UAlberta-EcoCar/DC-Motor-Controller/README.md

# DC-Motor-Controller
Our custom DC brushed motor controller
