UAlberta-EcoCar/DC-Motor-Controller/Motor Controller Code/README.txt

Source files to run on the motor controller's MCU go here
