UAlberta-EcoCar/DC-Motor-Controller/Motor Controller PCB/Motor Controller Logic Board/README.txt

If we deside to use an external mountable PCB for the voltage regulators,
it'll go here.
