UAlberta-EcoCar/DC-Motor-Controller/Motor Controller PCB/Motor Controller Power Board/Motor Controller Gerber 2017_10_10/README.txt

Schematic and Board files for the the motor controller here
