UAlberta-EcoCar/DC-Motor-Controller/Motor Controller PCB/Motor Controller Power Board/MotorControllerMainBoard.brd

## EAGLE design Motor Controller PCB/Motor Controller Power Board/MotorControllerMainBoard.brd (2017-10-19)

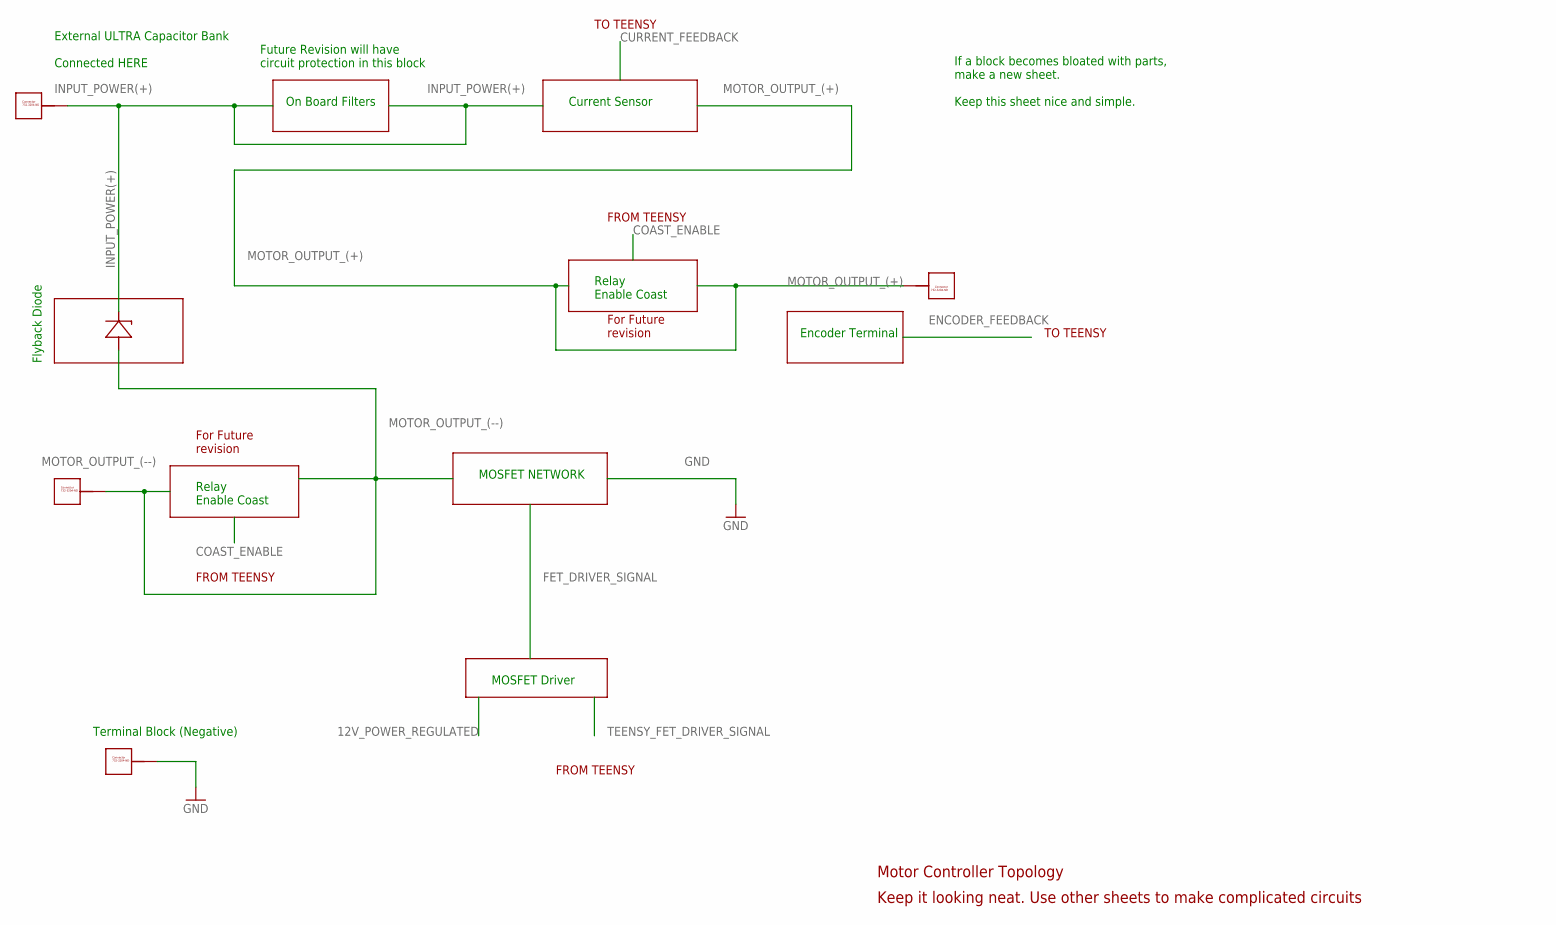
[picture p1: schematic MotorControllerMainBoard.sch, sheet 1, Main Board Topology]

Parts:
U$5: FLYBACK; TO
U$12, U$14, U$15, U$16: 732-3204-ND_CONNECTOR; 732-3204-ND

Connections:
GND: U$14.P$1, U$14.P$2, U$14.P$3, U$14.P$4, U$14.P$5, U$14.P$6, U$14.P$7, U$14.P$8, U$14.P$9, U$14.P$10; also elsewhere on the board
INPUT_POWER(+): U$5.CATHODE, U$12.P$1, U$12.P$2, U$12.P$3, U$12.P$4, U$12.P$5, U$12.P$6, U$12.P$7, U$12.P$8, U$12.P$9, U$12.P$10; also elsewhere on the board
MOTOR_OUTPUT_(+): U$15.P$1, U$15.P$2, U$15.P$3, U$15.P$4, U$15.P$5, U$15.P$6, U$15.P$7, U$15.P$8, U$15.P$9, U$15.P$10; also elsewhere on the board
MOTOR_OUTPUT_(--): U$5.ANODE, U$16.P$1, U$16.P$2, U$16.P$3, U$16.P$4, U$16.P$5, U$16.P$6, U$16.P$7, U$16.P$8, U$16.P$9, U$16.P$10; also elsewhere on the board

Notes on the sheet:
Current Sensor
On Board Filters
Flyback Diode
MOSFET NETWORK
If a block becomes bloated with parts, make a new sheet. Keep this sheet nice and simple.
MOSFET Driver
Encoder Terminal
TO TEENSY
FROM TEENSY
External ULTRA Capacitor Bank Connected HERE
Relay Enable Coast
Motor Controller Topology
Keep it looking neat. Use other sheets to make complicated circuits
For Future revision
Terminal Block (Negative)
Future Revision will have circuit protection in this block

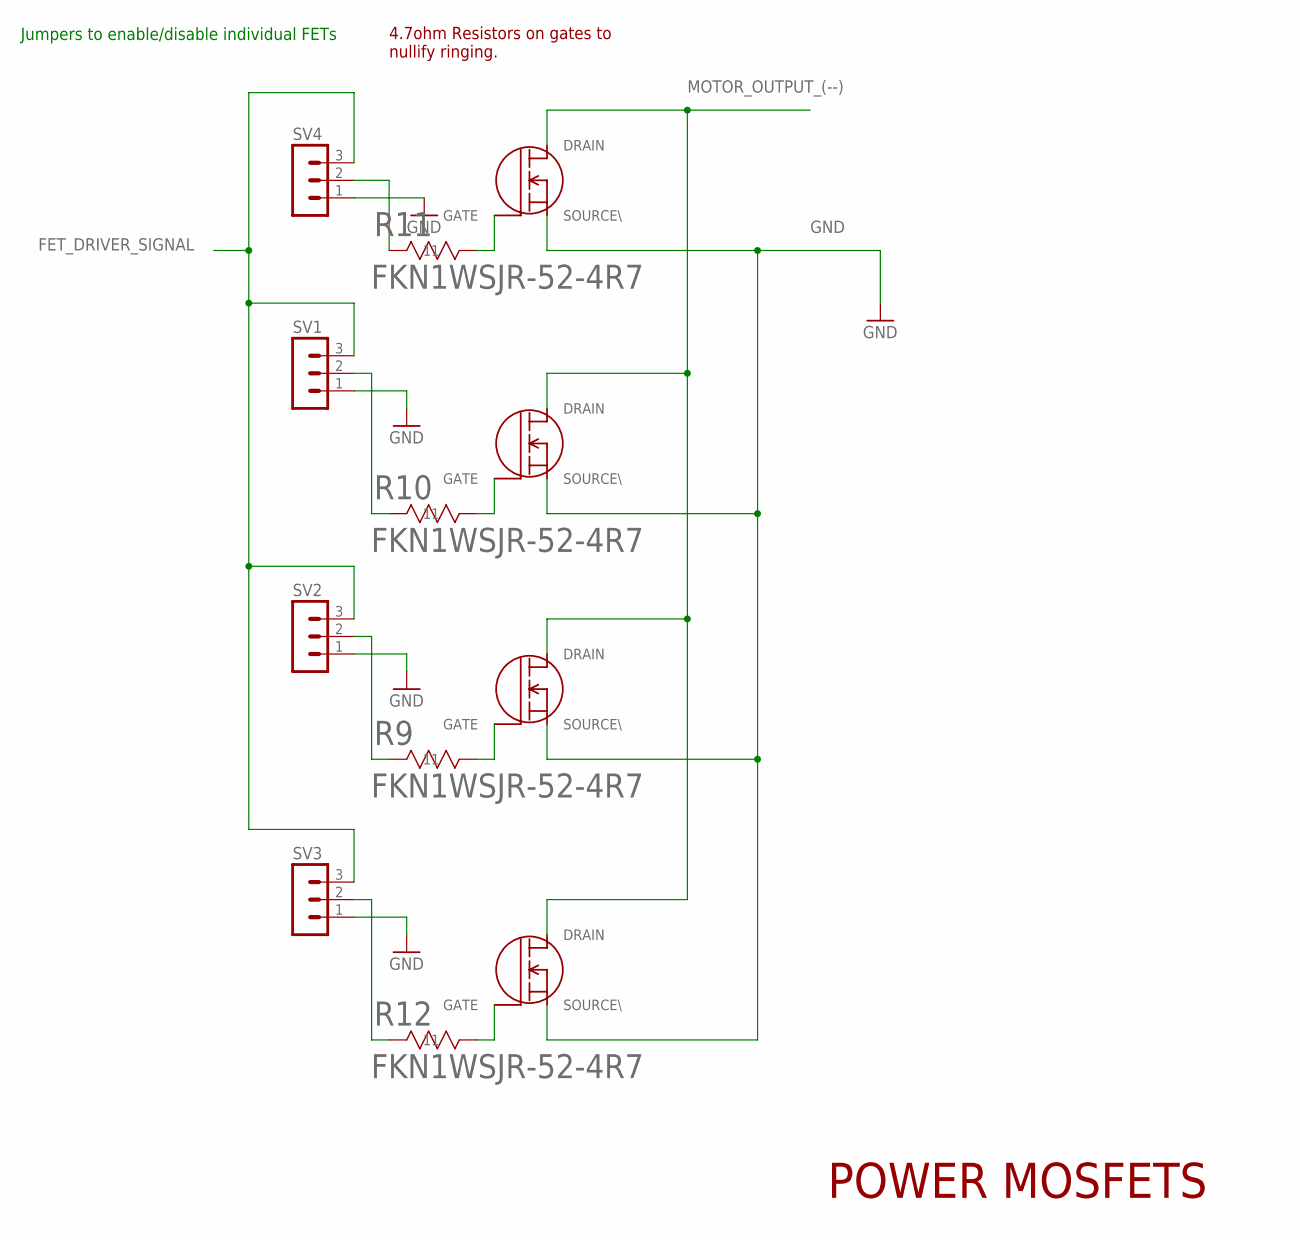
[picture p2: schematic MotorControllerMainBoard.sch, sheet 2, MOSFET NETWORK]

Parts:
R9, R10, R11, R12: FKN1WSJR-52-4R7; YAG_FKN50
SV1, SV2, SV3, SV4: MA03-1
U$1, U$2, U$3, U$4: NTMFS5C426NT1G; DNF5

Connections:
FET_DRIVER_SIGNAL: SV1.3, SV2.3, SV3.3, SV4.3; also elsewhere on the board
GND: SV1.1, SV2.1, SV3.1, U$1.SOURCE (SOURCE\), U$2.SOURCE (SOURCE\), U$3.SOURCE (SOURCE\), U$4.SOURCE (SOURCE\); also elsewhere on the board
MOTOR_OUTPUT_(--): U$1.DRAIN, U$2.DRAIN, U$3.DRAIN, U$4.DRAIN; also elsewhere on the board
unnamed: R10.2 (22), U$2.GATE
unnamed: R10.1 (11), SV1.2
unnamed: R12.1 (11), SV3.2
unnamed: R11.1 (11), SV4.2
unnamed: R11.2 (22), U$1.GATE
unnamed: R9.2 (22), U$3.GATE
unnamed: R12.2 (22), U$4.GATE
unnamed: R9.1 (11), SV2.2

Notes on the sheet:
POWER MOSFETS
Jumpers to enable/disable individual FETs
4.7ohm Resistors on gates to nullify ringing.

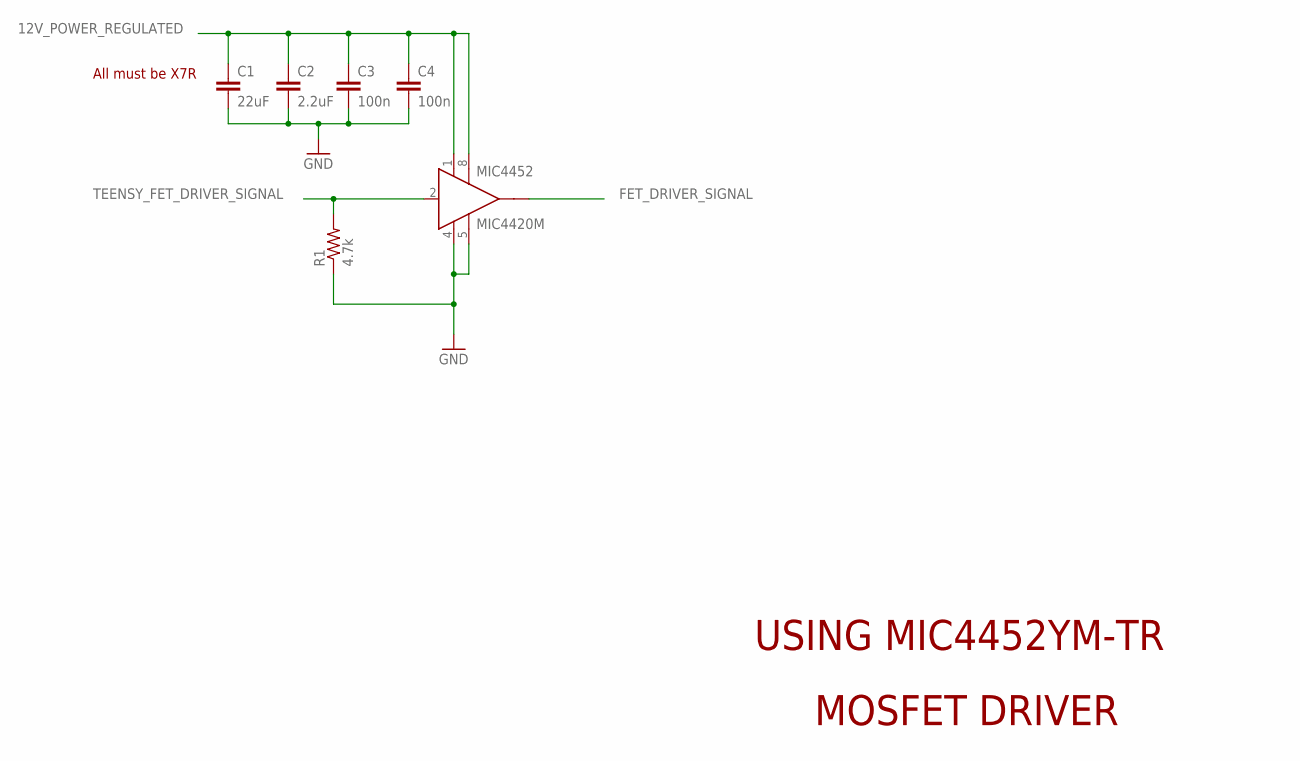
[picture p3: schematic MotorControllerMainBoard.sch, sheet 3, MOSFET Driver]

Parts:
C1: 22uF; C1206
C2: 2.2uF; C0805
C3, C4: 100n; C0603
MIC4452: MIC4420M; SO-08
R1: 4.7k; R0805

Connections:
12V_POWER_REGULATED: C1.1, C2.1, C3.1, C4.1, MIC4452.1 (VS), MIC4452.8 (VS1); also elsewhere on the board
FET_DRIVER_SIGNAL: MIC4452.6 (OUT); also elsewhere on the board
GND: C1.2, C2.2, C3.2, C4.2, MIC4452.4 (GND), MIC4452.5 (GND1), R1.1; also elsewhere on the board
TEENSY_FET_DRIVER_SIGNAL: MIC4452.2 (IN), R1.2; also elsewhere on the board

Notes on the sheet:
MOSFET DRIVER
USING MIC4452YM-TR
All must be X7R

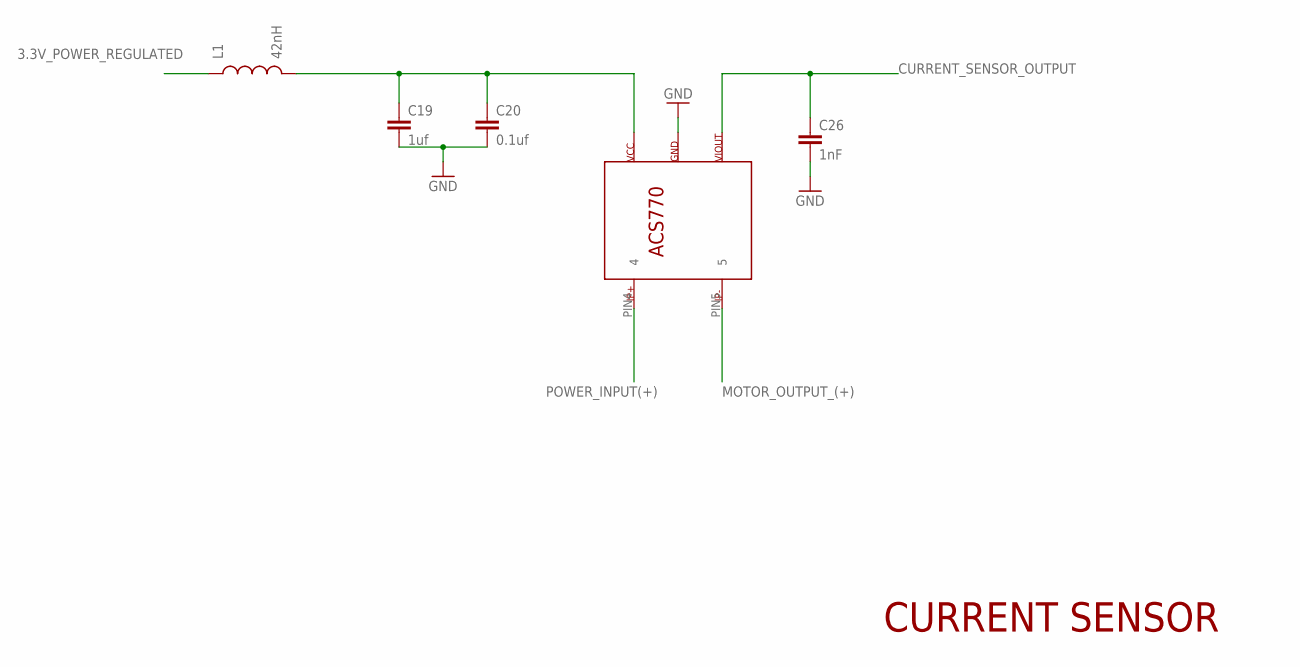
[picture p4: schematic MotorControllerMainBoard.sch, sheet 4, Current Sensor]

Parts:
C19: 1uf; C0805
C20: 0.1uf; C0805
C26: 1nF; C0805
L1: 42nH; 0805
U$9: ACS770LCB_CURRENTSENSOR

Connections:
3.3V_POWER_REGULATED: L1.1; also elsewhere on the board
CURRENT_SENSOR_OUTPUT: C26.1, U$9.PIN3 (3); also elsewhere on the board
GND: C19.2, C20.2, C26.2, U$9.PIN2 (2); also elsewhere on the board
MOTOR_OUTPUT_(+): U$9.PIN5 (5); also elsewhere on the board
unnamed: C19.1, C20.1, L1.2, U$9.PIN1 (1)
POWER_INPUT(+): U$9.PIN4 (4)

Notes on the sheet:
CURRENT SENSOR

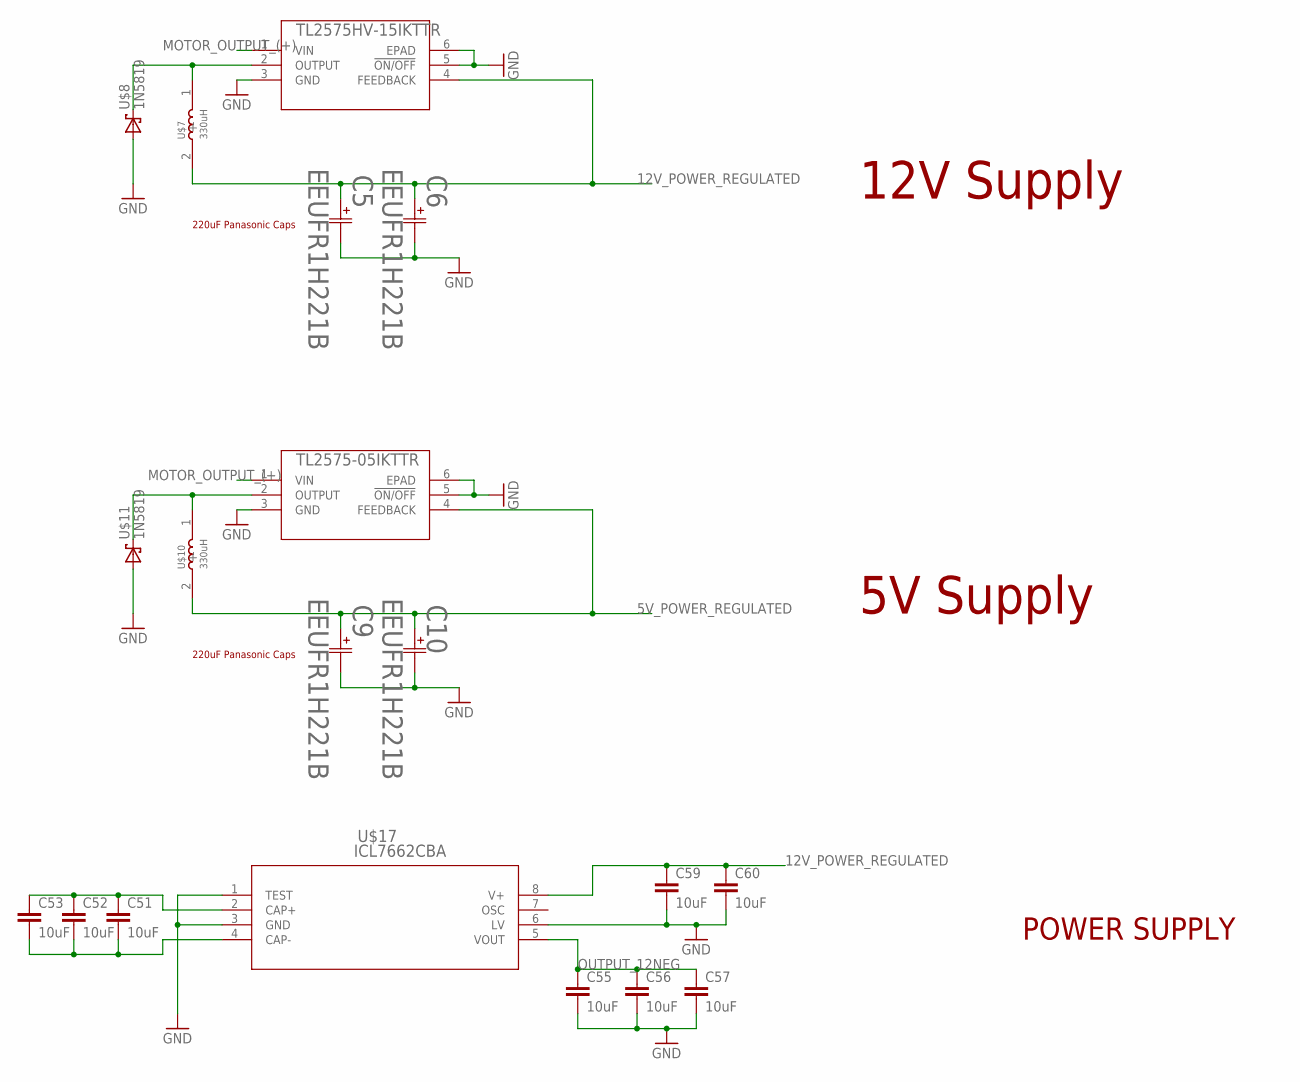
[picture p5: schematic MotorControllerMainBoard.sch, sheet 5, Power Supply]

Parts:
C5, C6, C9, C10: EEUFR1H221B; CAP_PAN_10X16
C51, C52, C53, C55, C56, C57, C59, C60: 10uF; C0805
U$6: TL2575HV-15IKTTR; KTT5_6P22X6P86
U$7, U$10: 330uH; INDUCTOR_SMD_FOOTPRINT
U$8, U$11: 1N5819; SOD3715X135N
U$13: TL2575-05IKTTR; KTT5_6P22X6P86
U$17: ICL7662CBA; SO08

Connections:
5V_POWER_REGULATED: C9.1 (11), C10.1 (11), U$10.2 (-), U$13.4 (FEEDBACK); also elsewhere on the board
12V_POWER_REGULATED: C5.1 (11), C6.1 (11), C59.1, C60.1, U$6.4 (FEEDBACK), U$7.2 (-), U$17.8 (V+); also elsewhere on the board
GND: C5.2 (22), C6.2 (22), C9.2 (22), C10.2 (22), C55.2, C56.2, C57.2, C59.2, C60.2, U$6.3 (GND), U$6.5 (!ON/OFF), U$6.6 (EPAD), U$8.A, U$11.A, U$13.3 (GND), U$13.5 (!ON/OFF), U$13.6 (EPAD), U$17.1 (TEST), U$17.3 (GND), U$17.6 (LV); also elsewhere on the board
MOTOR_OUTPUT_(+): U$6.1 (VIN), U$13.1 (VIN); also elsewhere on the board
unnamed: U$6.2 (OUTPUT), U$7.1 (+), U$8.C (K)
unnamed: U$10.1 (+), U$11.C (K), U$13.2 (OUTPUT)
unnamed: C51.1, C52.1, C53.1, U$17.2 (CAP+)
unnamed: C51.2, C52.2, C53.2, U$17.4 (CAP-)
OUTPUT_12NEG: C55.1, C56.1, C57.1, U$17.5 (VOUT); also elsewhere on the board

Notes on the sheet:
POWER SUPPLY
12V Supply
5V Supply
220uF Panasonic Caps

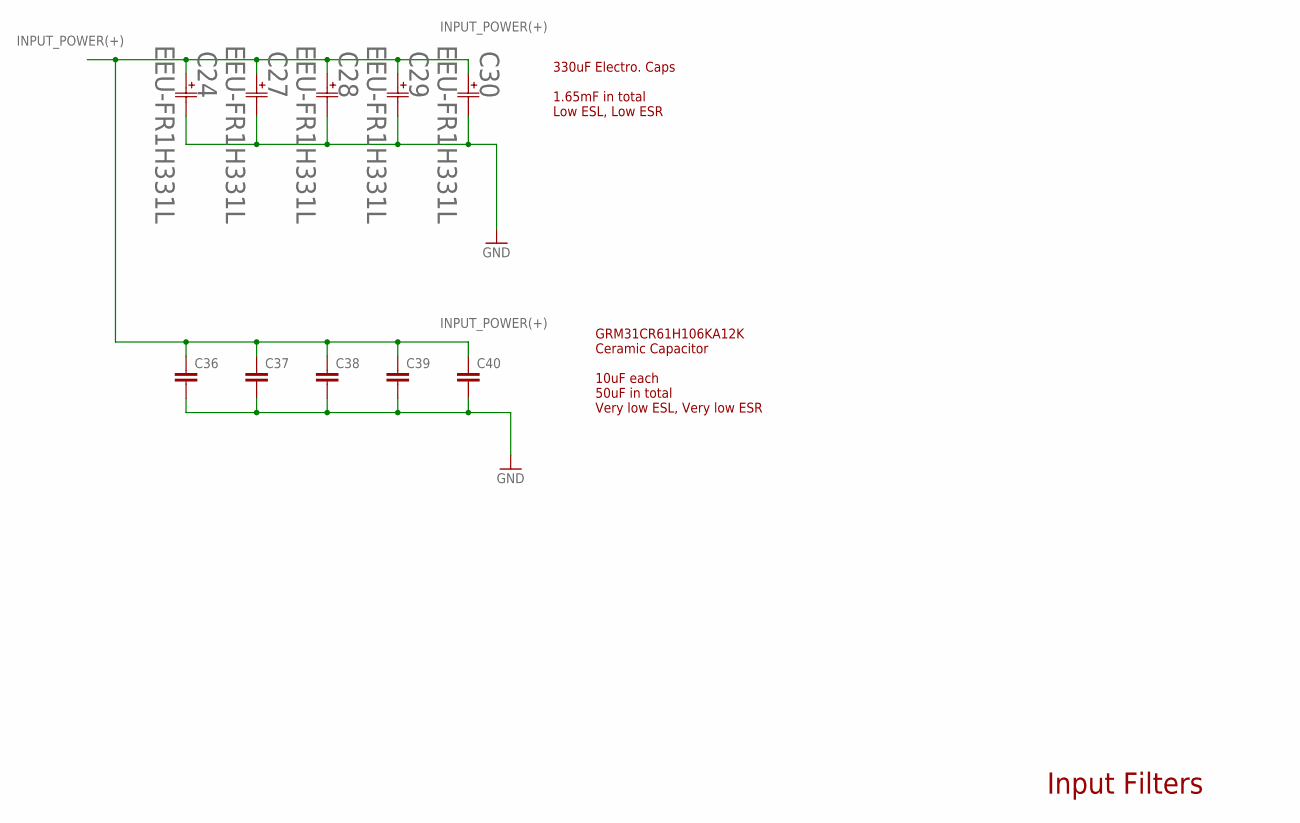
[picture p6: schematic MotorControllerMainBoard.sch, sheet 6, Input Filters]

Parts:
C24, C27, C28, C29, C30: EEU-FR1H331L; CAP_EEUFC_10X25
C36, C37, C38, C39, C40: C-EUC1206; C1206

Connections:
GND: C24.2 (22), C27.2 (22), C28.2 (22), C29.2 (22), C30.2 (22), C36.2, C37.2, C38.2, C39.2, C40.2; also elsewhere on the board
INPUT_POWER(+): C24.1 (11), C27.1 (11), C28.1 (11), C29.1 (11), C30.1 (11), C36.1, C37.1, C38.1, C39.1, C40.1; also elsewhere on the board

Notes on the sheet:
Input Filters
GRM31CR61H106KA12K Ceramic Capacitor 10uF each 50uF in total Very low ESL, Very low ESR
330uF Electro. Caps 1.65mF in total Low ESL, Low ESR

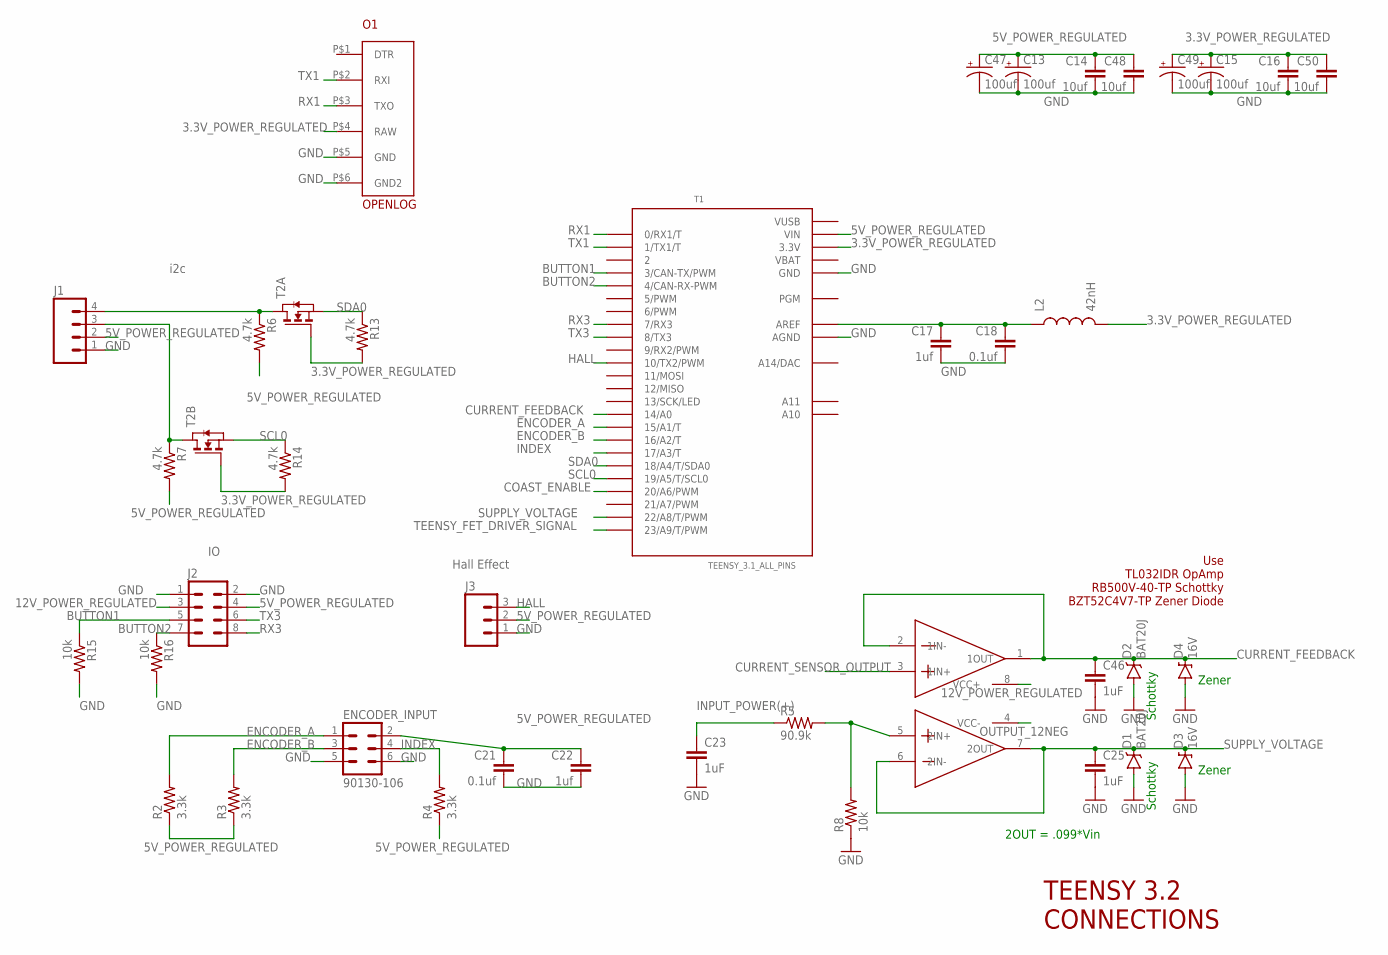
[picture p7: schematic MotorControllerMainBoard.sch, sheet 7, Teensy]

Parts:
AD8512ARZ: TL072CDT; D8
C13, C15, C47, C49: 100uf; PANASONIC_C
C14, C16, C48, C50: 10uf; C0805
C17, C22: 1uf; C0805
C18, C21: 0.1uf; C0805
C23, C25, C46: 1uF; C0805
D1, D2: BAT20J; SOD-323
D3, D4: 16V; SOD-123
ENCODER_INPUT: 90130-106; 90130-1?06
J1: M04PTH; 1X04
J2: M04X2; 2X4
J3: M03PTH; 1X03
L2: 42nH; 0805
O1: OPENLOG
R2, R3, R4: 3.3k; R0805
R5: 90.9k; R0805
R6, R7, R13, R14: 4.7k; 0805
R8: 10k; R0805
R15, R16: 10k; 0805
T1: TEENSY_3.1_ALL_PINS; TEENSY3-ALL_PINS
T2: NMOS2SO8; SO8

Connections:
3.3V_POWER_REGULATED: C15.+, C16.1, C49.+, C50.1, L2.2, O1.P$4 (RAW), R13.2, R14.2, T1.3.3V, T1.3.3V1 (3.3V), T2.2 (G), T2.4 (G); also elsewhere on the board
5V_POWER_REGULATED: C13.+, C14.1, C21.1, C22.1, C47.+, C48.1, ENCODER_INPUT.2, J1.2, J2.4, J3.2, R2.1, R3.1, R4.1, R6.2, R7.2, T1.VIN; also elsewhere on the board
12V_POWER_REGULATED: AD8512ARZ.8 (VCC+), J2.3; also elsewhere on the board
BUTTON1: J2.5, R15.1, T1.3 (3/CAN-TX/PWM)
BUTTON2: J2.7, R16.1, T1.4 (4/CAN-RX-PWM)
COAST_ENABLE: T1.20/A6 (20/A6/PWM)
CURRENT_FEEDBACK: AD8512ARZ.1 (1OUT), AD8512ARZ.2 (1IN-), C46.1, D2.C, D4.C, T1.14/A0
CURRENT_SENSOR_OUTPUT: AD8512ARZ.3 (1IN+); also elsewhere on the board
ENCODER_A: ENCODER_INPUT.1, R2.2, T1.15/A1 (15/A1/T)
ENCODER_B: ENCODER_INPUT.3, R3.2, T1.16/A2 (16/A2/T)
GND: C13.-, C14.2, C15.-, C16.2, C17.2, C18.2, C21.2, C22.2, C23.2, C25.2, C46.2, C47.-, C48.2, C49.-, C50.2, D1.A, D2.A, D3.A, D4.A, ENCODER_INPUT.5, ENCODER_INPUT.6, J1.1, J2.1, J2.2, J3.1, O1.P$5 (GND), O1.P$6 (GND2), R8.1, R15.2, R16.2, T1.AGND, T1.GND, T1.GND1 (GND); also elsewhere on the board
HALL: J3.3, T1.10 (10/TX2/PWM)
INDEX: ENCODER_INPUT.4, R4.2, T1.17/A3 (17/A3/T)
INPUT_POWER(+): C23.1, R5.1; also elsewhere on the board
unnamed: AD8512ARZ.5 (2IN+), R5.2, R8.2
unnamed: C17.1, C18.1, L2.1, T1.AREF
unnamed: J1.3, R7.1, T2.5 (D), T2.6 (D)
unnamed: J1.4, R6.1, T2.7 (D), T2.8 (D)
OUTPUT_12NEG: AD8512ARZ.4 (VCC-); also elsewhere on the board
RX1: O1.P$3 (TXO), T1.0 (0/RX1/T)
RX3: J2.8, T1.7 (7/RX3)
SCL0: R14.1, T1.19/A5 (19/A5/T/SCL0), T2.3 (S)
SDA0: R13.1, T1.18/A4 (18/A4/T/SDA0), T2.1 (S)
SUPPLY_VOLTAGE: AD8512ARZ.6 (2IN-), AD8512ARZ.7 (2OUT), C25.1, D1.C, D3.C, T1.22/A8 (22/A8/T/PWM)
TEENSY_FET_DRIVER_SIGNAL: T1.23/A9 (23/A9/T/PWM); also elsewhere on the board
TX1: O1.P$2 (RXI), T1.1 (1/TX1/T)
TX3: J2.6, T1.8 (8/TX3)
VBAT: T1.VBAT
VUSB: T1.VUSB

Notes on the sheet:
TEENSY 3.2 CONNECTIONS
2OUT = .099*Vin
Use TL032IDR OpAmp RB500V-40-TP Schottky BZT52C4V7-TP Zener Diode
Zener
Schottky
i2c
Hall Effect

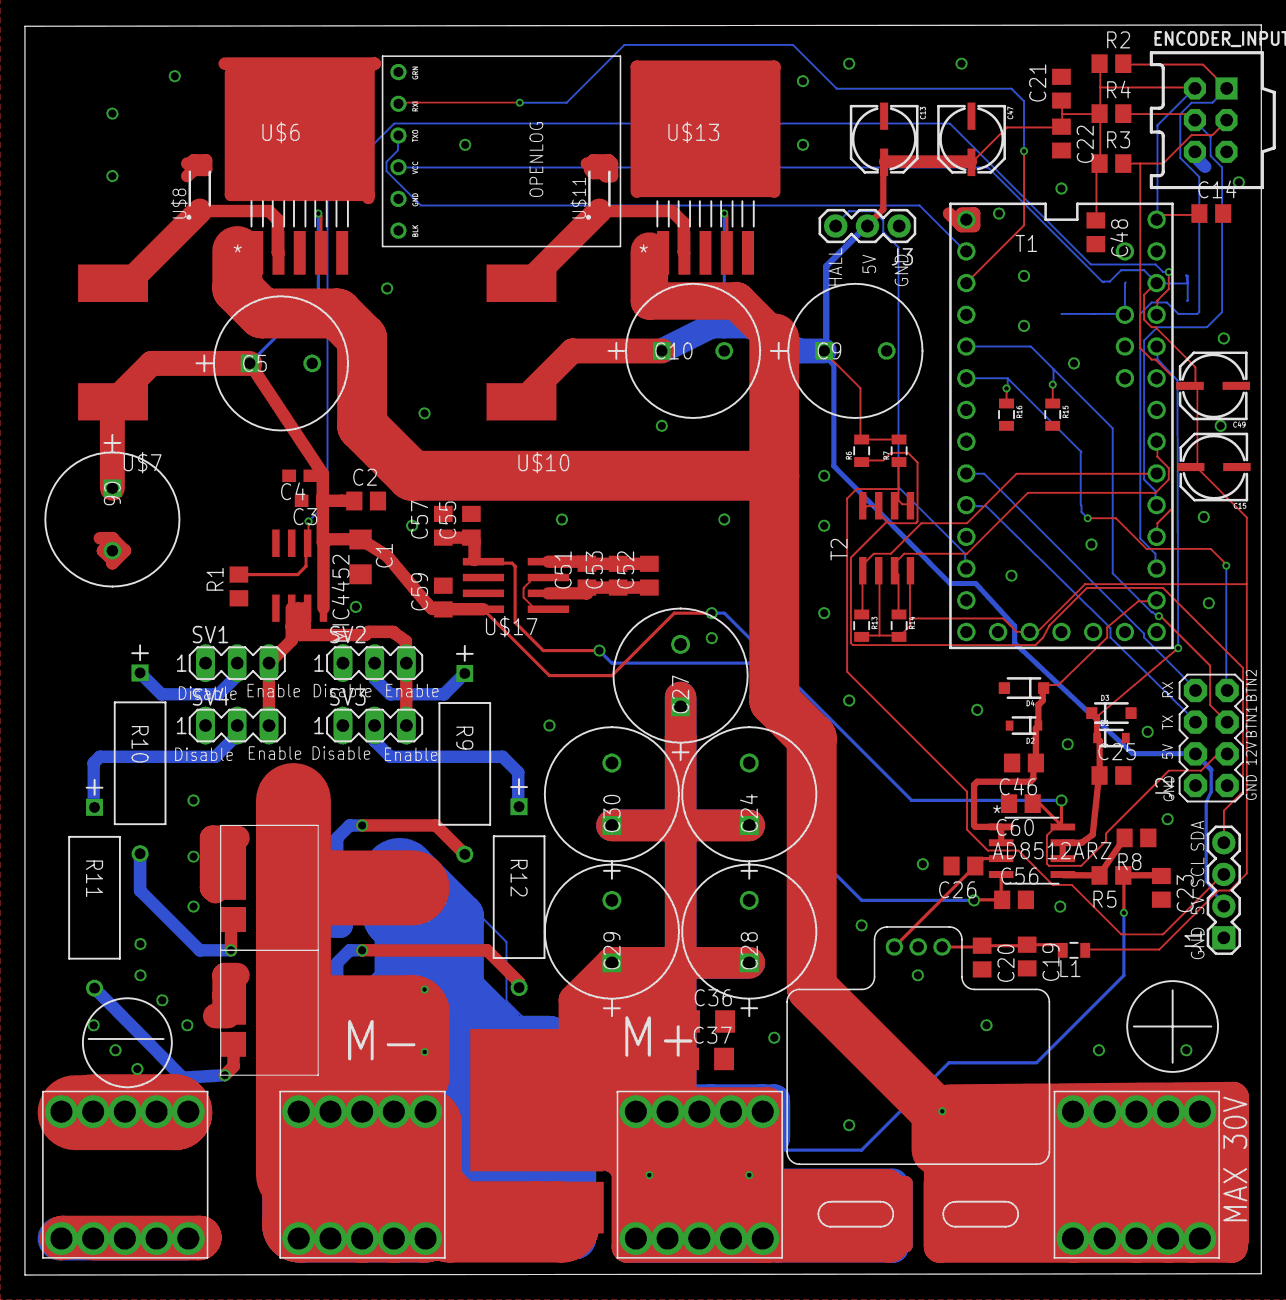
[picture p8: board MotorControllerMainBoard.brd from above]

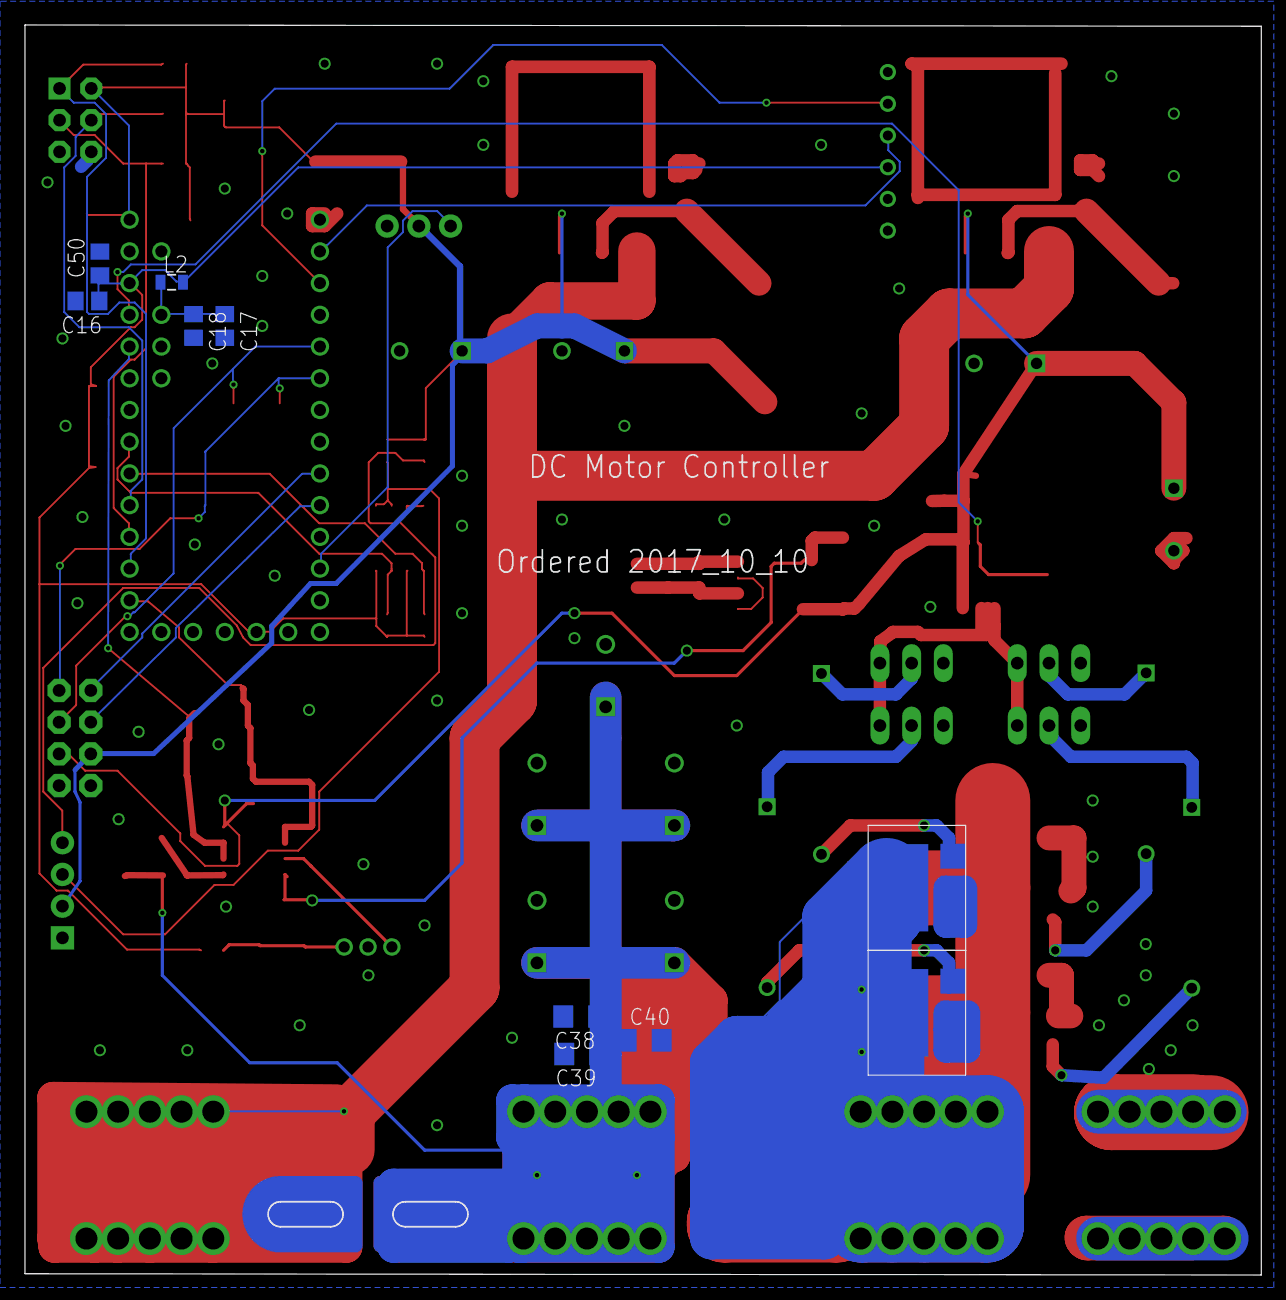
[picture p9: board MotorControllerMainBoard.brd from below]

Board: 2 copper layers, 99.0 x 100.1 mm, 96 parts (10 on the bottom side), 42 nets.
