UAlberta-EcoCar/DC-Motor-Controller/Motor Controller Code/src/PID.hpp

#ifndef PID_HPP
#define PID_HPP

#include "mbed.h"
#include "rtos.h"
#include <limits.h>


////////////////////
//PID CLASS
////////////////////


class PID {

  private:

  	int32_t duty_cycle;    //output to the actuator (eg motor)
  	uint16_t p, i, d;
    uint16_t ADC_value;
  	int32_t sum;           //sum for the Integral term
  	uint16_t reference;    //reference
  	int32_t error;         //error with respect to the reference, used for calculating the slope
  	int32_t slope;         //used for the Derivative term
  	int32_t previous_cycle;//previous error value, used to calculate the Derivative term
  	uint16_t num_samples;  //number of ADC samples per cycle
  	AnalogIn *feedBack;    //ADC object used for feedback, eg a current sensor

  public:

  	//constructors
  	PID();
  	PID(AnalogIn *feedBack, uint16_t num_samples, uint16_t p, uint16_t i, uint16_t d); //feedBack is a pointer to an ADC object, for current sensing

  	//methods
  	uint16_t PID_calc(); //needs to be called every cycle
  	void set_reference(uint16_t reference);
  	void set_feedBack(AnalogIn *feedBack);
  	void set_p(uint16_t p);
  	void set_i(uint16_t i);
  	void set_d(uint16_t d);
  	int32_t get_error();
  	uint16_t analog_read();

};


#endif
