UAlberta-EcoCar/DC-Motor-Controller/(commit log)

2017-05-29 Started a general folder layout
    Gotta keep organized !
    [Desision SpreedSheet.xlsx]
2017-06-02 Setup the Topology
    Fill out the boxes! Make use of sheets to keep it simple and tidy.
    [MotorControllerMainBoard.sch]
2017-06-02 Created PID class
    Started working on the PID class
2017-06-03 Added onto PID class
    Continued work on the PID class
2017-06-03 Tested it with a physical setup
    Tested the code with a physical setup, a teensy and a small DC motor. It
    works.
2017-06-09 Added to desision spreadsheet
    [Desision SpreedSheet.xlsx]
2017-06-15 Added Mosfet Network Block
    Selected a nMOS to use and added it to the eagle schematic.
    Didnt have an eagle part, so I made. I made the pads extra large so we
    can get to it with an iron.
    [Desision SpreedSheet.xlsx, MotorControllerMainBoard.sch]
2017-06-16 Added MOSFET Driver
    [Desision SpreedSheet.xlsx, MotorControllerMainBoard.sch]
2017-10-19 PCB Logic/Power V1.0 (#1)
    * Added Teensy Symbol
    * Added Flyback Diode
    Should able to mount the active diode and the schotky diode onto the pad
    layout. Dispite them having different packages.
    * Added libraries for the 5V and 15V regulator
    * Added datasheet for the 15V and 5V regulator
    They have the same data sheet;
    The TL2575.
    * Created Inductor Symbol
    * Added Capacitor Library
    * Updated Eagle Library
    Updated eagle library, will work on power supply tomorrow
    * Worked on 15V and 5V Supply
    * Removed Trimpot on Supply
    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
    [MotorControllerMainBoard.GBL, MotorControllerMainBoard.GBO, MotorControllerMainBoard.GBP, MotorControllerMainBoard.GBS, MotorControllerMainBoard.GTL, MotorControllerMainBoard.GTO, MotorControllerMainBoard.GTP, MotorControllerMainBoard.GTS]
2017-10-19 Changed the names of the PCB folders to be better represent them
    [MotorControllerMainBoard.GBL, MotorControllerMainBoard.GBO, MotorControllerMainBoard.GBP, MotorControllerMainBoard.GBS, MotorControllerMainBoard.GTL, MotorControllerMainBoard.GTO, MotorControllerMainBoard.GTP, MotorControllerMainBoard.GTS]
2017-10-22 Added link to gDrive BOM
