UAlberta-EcoCar/DC-Motor-Controller/(notices)

Notices in the files:
parts and their libraries:
SparkFun-Capacitors: Licensing: Creative Commons ShareAlike 4.0 International - https://creativecommons.org/licenses/by-sa/4.0
con-molex-c-grid: Copyright (C) 2009, Bob Starr
SparkFun: Licensing: CC v3.0 Share-Alike You are welcome to use this library for commercial purposes.
